pdaxrom/Z-pdaXrom-TV/projects/pal-color-demo/README

Original sources for Papilio TV Output Wing

http://papilio.cc/index.php?n=Playground.TVOutputWing
