pdaxrom/Z-pdaXrom-TV/hardware-lcd-sdram/main.brd

## EAGLE design hardware-lcd-sdram/main.brd (2018-05-11)

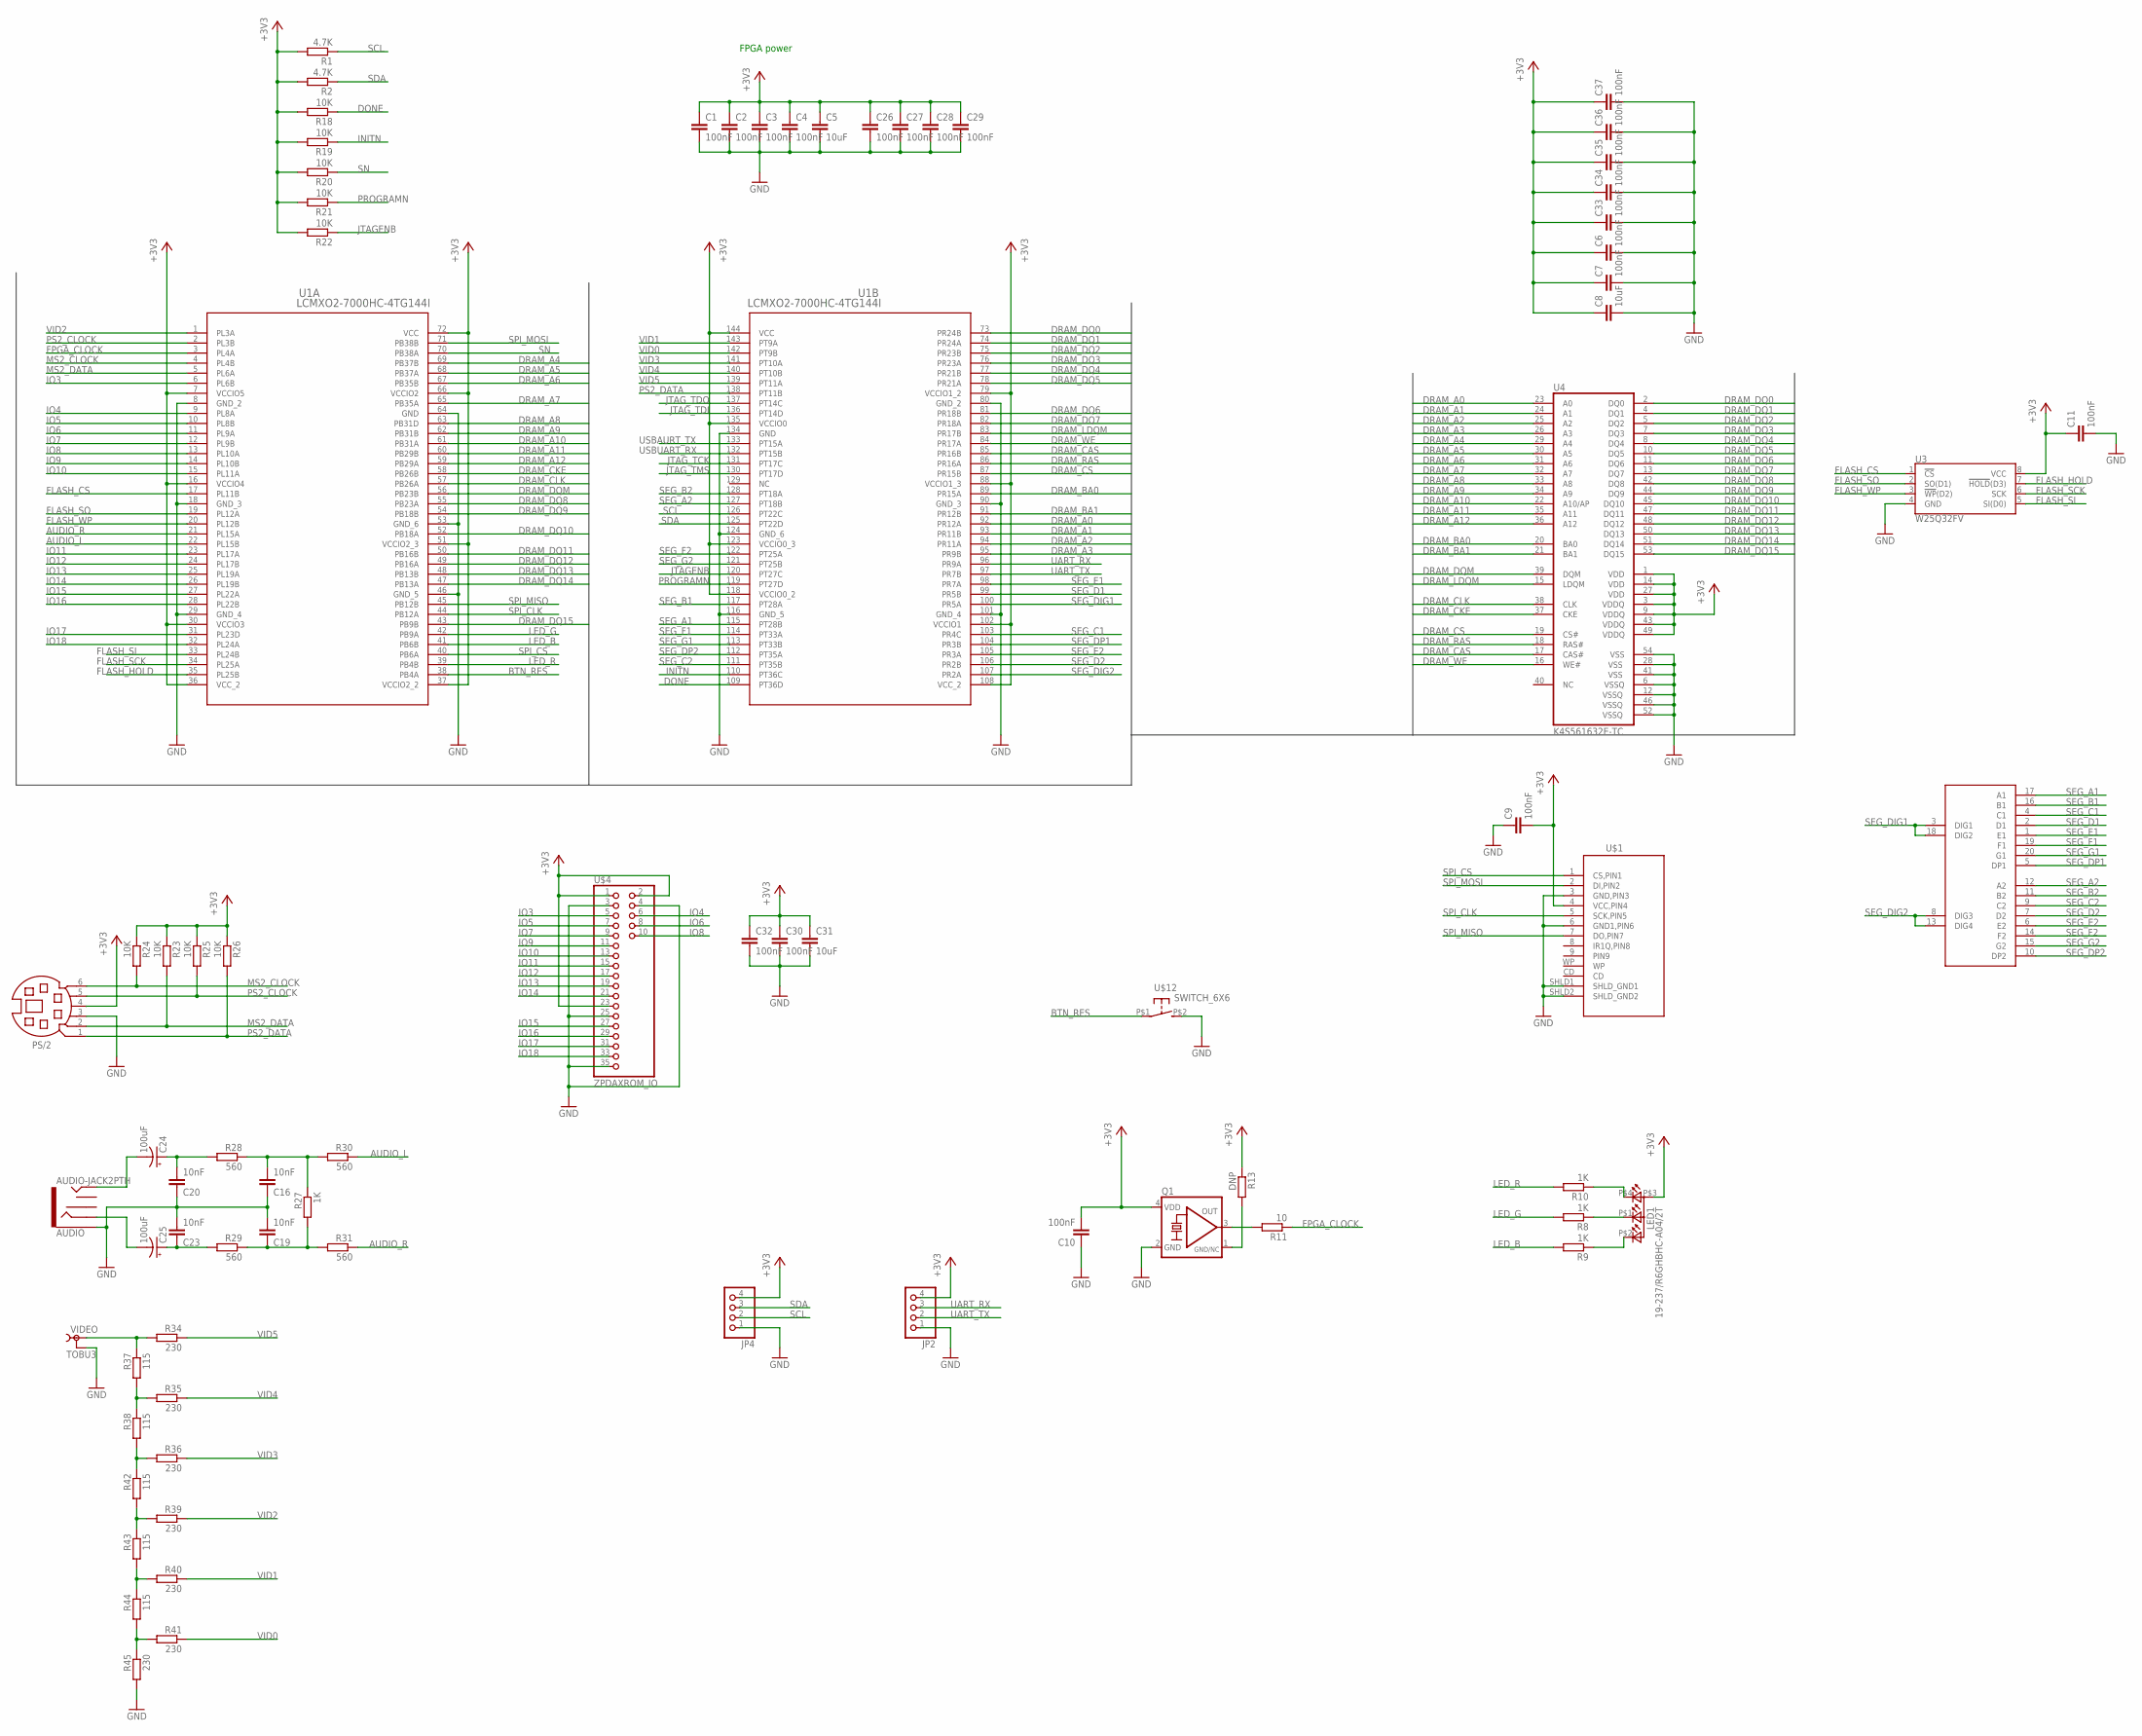
[picture p1: schematic main.sch, sheet 1]

Parts:
AUDIO: AUDIO-JACK2PTH; AUDIO-JACK
C1, C2, C3, C4, C6, C7, C9, C10, C11, C26, C27, C28, C29, C30, C32, C33, C34, C35, C36, C37: 100nF; C0603
C5, C8, C31: 10uF; C0805
C16, C19, C20, C23: 10nF; C0603
C24, C25: 100uF; EIA7343
JP2, JP4: PINHD-1X4; 1X04
LED1: 19-237/R6GHBHC-A04/2T
PS/2: MD06SS; MDIN06SS
Q1: KXO-TCXO-CMOS-82; 7.0X5.0_KXO-82-TCXO
R1, R2: 4.7K; R0603
R8, R9, R10, R27: 1K; R0603
R11: 10; R0603
R13: DNP; R0603
R18, R19, R20, R21, R22, R23, R24, R25, R26: 10K; R0603
R28, R29, R30, R31: 560; R0603
R34, R35, R36, R39, R40, R41, R45: 230; R0603
R37, R38, R42, R43, R44: 115; R0603
U1: LCMXO2-7000HC-4TG144I; TQFP144
U3: W25Q32FV; SOIC-8
U4: K4S561632E-TC; TSOP54
U$1: FCI_SD_SOCKET; SD-MMC_SOCKET-PP
U$3: GS2020CR-G; GS2020CR
U$4: ZPDAXROM_IO; 2X18_ZPDAXROM_IO
U$12: SWITCH_6X6
VIDEO: TOBU3

Connections:
+3V3: C1.1, C2.1, C3.1, C4.1, C5.1, C6.1, C7.1, C8.1, C9.2, C10.2, C11.1, C26.1, C27.1, C28.1, C29.1, C30.1, C31.1, C32.1, C33.1, C34.1, C35.1, C36.1, C37.1, JP2.4, JP4.4, LED1.P$3 (A), PS/2.4, Q1.4 (VDD), R1.2, R2.2, R13.1, R18.2, R19.2, R20.2, R21.2, R22.2, R23.1, R24.1, R25.1, R26.1, U1.7 (VCCIO5), U1.16 (VCCIO4), U1.30 (VCCIO3), U1.36 (VCC_2), U1.37 (VCCIO2_2), U1.51 (VCCIO2_3), U1.66 (VCCIO2), U1.72 (VCC), U1.79 (VCCIO1_2), U1.88 (VCCIO1_3), U1.102 (VCCIO1), U1.108 (VCC_2), U1.118 (VCCIO0_2), U1.123 (VCCIO0_3), U1.135 (VCCIO0), U1.144 (VCC), U3.8 (VCC), U4.1 (VDD), U4.3 (VDDQ), U4.9 (VDDQ), U4.14 (VDD), U4.27 (VDD), U4.43 (VDDQ), U4.49 (VDDQ), U$1.4 (VCC,PIN4), U$4.1, U$4.2, U$4.23; also elsewhere on the board
AUDIO_L: R30.1, U1.22 (PL15B)
AUDIO_R: R31.1, U1.21 (PL15A)
BTN_RES: U1.38 (PB4A), U$12.P$1
DONE: R18.1, U1.109 (PT36D)
DRAM_A0: U1.92 (PR12A), U4.23 (A0)
DRAM_A1: U1.93 (PR11B), U4.24 (A1)
DRAM_A2: U1.94 (PR11A), U4.25 (A2)
DRAM_A3: U1.95 (PR9B), U4.26 (A3)
DRAM_A4: U1.69 (PB37B), U4.29 (A4)
DRAM_A5: U1.68 (PB37A), U4.30 (A5)
DRAM_A6: U1.67 (PB35B), U4.31 (A6)
DRAM_A7: U1.65 (PB35A), U4.32 (A7)
DRAM_A8: U1.63 (PB31D), U4.33 (A8)
DRAM_A9: U1.62 (PB31B), U4.34 (A9)
DRAM_A10: U1.61 (PB31A), U4.22 (A10/AP)
DRAM_A11: U1.60 (PB29B), U4.35 (A11)
DRAM_A12: U1.59 (PB29A), U4.36 (A12)
DRAM_BA0: U1.89 (PR15A), U4.20 (BA0)
DRAM_BA1: U1.91 (PR12B), U4.21 (BA1)
DRAM_CAS: U1.85 (PR16B), U4.17 (CAS#)
DRAM_CKE: U1.58 (PB26B), U4.37 (CKE)
DRAM_CLK: U1.57 (PB26A), U4.38 (CLK)
DRAM_CS: U1.87 (PR15B), U4.19 (CS#)
DRAM_DQ0: U1.73 (PR24B), U4.2 (DQ0)
DRAM_DQ1: U1.74 (PR24A), U4.4 (DQ1)
DRAM_DQ2: U1.75 (PR23B), U4.5 (DQ2)
DRAM_DQ3: U1.76 (PR23A), U4.7 (DQ3)
DRAM_DQ4: U1.77 (PR21B), U4.8 (DQ4)
DRAM_DQ5: U1.78 (PR21A), U4.10 (DQ5)
DRAM_DQ6: U1.81 (PR18B), U4.11 (DQ6)
DRAM_DQ7: U1.82 (PR18A), U4.13 (DQ7)
DRAM_DQ8: U1.55 (PB23A), U4.42 (DQ8)
DRAM_DQ9: U1.54 (PB18B), U4.44 (DQ9)
DRAM_DQ10: U1.52 (PB18A), U4.45 (DQ10)
DRAM_DQ11: U1.50 (PB16B), U4.47 (DQ11)
DRAM_DQ12: U1.49 (PB16A), U4.48 (DQ12)
DRAM_DQ13: U1.48 (PB13B), U4.50 (DQ13)
DRAM_DQ14: U1.47 (PB13A), U4.51 (DQ14)
DRAM_DQ15: U1.43 (PB9B), U4.53 (DQ15)
DRAM_DQM: U1.56 (PB23B), U4.39 (DQM)
DRAM_LDQM: U1.83 (PR17B), U4.15 (LDQM)
DRAM_RAS: U1.86 (PR16A), U4.18 (RAS#)
DRAM_WE: U1.84 (PR17A), U4.16 (WE#)
FLASH_CS: U1.17 (PL11B), U3.1 (!CS!)
FLASH_HOLD: U1.35 (PL25B), U3.7 (!HOLD!(D3))
FLASH_SCK: U1.34 (PL25A), U3.6 (SCK)
FLASH_SI: U1.33 (PL24B), U3.5 (SI(D0))
FLASH_SO: U1.19 (PL12A), U3.2 (SO(D1))
FLASH_WP: U1.20 (PL12B), U3.3 (!WP!(D2))
FPGA_CLOCK: R11.1, U1.3 (PL4A)
GND: AUDIO.SLEEVE, C1.2, C2.2, C3.2, C4.2, C5.2, C6.2, C7.2, C8.2, C9.1, C10.1, C11.2, C16.1, C19.2, C20.1, C23.2, C26.2, C27.2, C28.2, C29.2, C30.2, C31.2, C32.2, C33.2, C34.2, C35.2, C36.2, C37.2, JP2.1, JP4.1, PS/2.3, Q1.2 (GND), R45.2, U1.8 (GND_2), U1.18 (GND_3), U1.29 (GND_4), U1.46 (GND_5), U1.53 (GND_6), U1.64 (GND), U1.80 (GND_2), U1.90 (GND_3), U1.101 (GND_4), U1.116 (GND_5), U1.124 (GND_6), U1.134 (GND), U3.4 (GND), U4.6 (VSSQ), U4.12 (VSSQ), U4.28 (VSS), U4.41 (VSS), U4.46 (VSSQ), U4.52 (VSSQ), U4.54 (VSS), U$1.3 (GND,PIN3), U$1.6 (GND1,PIN6), U$1.SHLD1 (SHLD_GND1), U$1.SHLD2 (SHLD_GND2), U$4.3, U$4.4, U$4.25, U$4.35, U$12.P$2 (S), VIDEO.2, VIDEO.2@1 (2), VIDEO.2@2 (2); also elsewhere on the board
INITN: R19.1, U1.110 (PT36C)
IO3: U1.6 (PL6B), U$4.5
IO4: U1.9 (PL8A), U$4.6
IO5: U1.10 (PL8B), U$4.7
IO6: U1.11 (PL9A), U$4.8
IO7: U1.12 (PL9B), U$4.9
IO8: U1.13 (PL10A), U$4.10
IO9: U1.14 (PL10B), U$4.11
IO10: U1.15 (PL11A), U$4.13
IO11: U1.23 (PL17A), U$4.15
IO12: U1.24 (PL17B), U$4.17
IO13: U1.25 (PL19A), U$4.19
IO14: U1.26 (PL19B), U$4.21
IO15: U1.27 (PL22A), U$4.27
IO16: U1.28 (PL22B), U$4.29
IO17: U1.31 (PL23D), U$4.31
IO18: U1.32 (PL24A), U$4.33
JTAGENB: R22.1, U1.120 (PT27C)
JTAG_TCK: U1.131 (PT17C); also elsewhere on the board
JTAG_TDI: U1.136 (PT14D); also elsewhere on the board
JTAG_TDO: U1.137 (PT14C); also elsewhere on the board
JTAG_TMS: U1.130 (PT17D); also elsewhere on the board
LED_B: R9.2, U1.41 (PB6B)
LED_G: R8.2, U1.42 (PB9A)
LED_R: R10.2, U1.39 (PB4B)
MS2_CLOCK: PS/2.6, R24.2, U1.4 (PL4B)
MS2_DATA: PS/2.2, R23.2, U1.5 (PL6A)
unnamed: LED1.P$4 (CRED), R10.1
unnamed: Q1.3 (OUT), R11.2
unnamed: LED1.P$1 (CBLUE), R8.1
unnamed: LED1.P$2 (CGREEN), R9.1
unnamed: Q1.1 (GND/NC), R13.2
unnamed: C19.1, R27.2, R29.1, R31.2
unnamed: C16.2, R27.1, R28.1, R30.2
unnamed: AUDIO.TIP, C24.C (-)
unnamed: C23.1, C25.A (+), R29.2
unnamed: C20.2, C24.A (+), R28.2
unnamed: AUDIO.RING, C25.C (-)
unnamed: R34.2, R37.1, VIDEO.1
unnamed: R35.2, R37.2, R38.1
unnamed: R36.2, R38.2, R42.1
unnamed: R39.2, R42.2, R43.1
unnamed: R40.2, R43.2, R44.1
unnamed: R41.2, R44.2, R45.1
PROGRAMN: R21.1, U1.119 (PT27D)
PS2_CLOCK: PS/2.5, R25.2, U1.2 (PL3B)
PS2_DATA: PS/2.1, R26.2, U1.138 (PT11B)
SCL: JP4.2, R1.1, U1.126 (PT22C)
SDA: JP4.3, R2.1, U1.125 (PT22D)
SEG_A1: U1.115 (PT28B), U$3.17 (A1)
SEG_A2: U1.127 (PT18B), U$3.12 (A2)
SEG_B1: U1.117 (PT28A), U$3.16 (B1)
SEG_B2: U1.128 (PT18A), U$3.11 (B2)
SEG_C1: U1.103 (PR4C), U$3.4 (C1)
SEG_C2: U1.111 (PT35B), U$3.9 (C2)
SEG_D1: U1.99 (PR5B), U$3.2 (D1)
SEG_D2: U1.106 (PR2B), U$3.7 (D2)
SEG_DIG1: U1.100 (PR5A), U$3.3 (DIG1), U$3.18 (DIG2)
SEG_DIG2: U1.107 (PR2A), U$3.8 (DIG3), U$3.13 (DIG4)
SEG_DP1: U1.104 (PR3B), U$3.5 (DP1)
SEG_DP2: U1.112 (PT35A), U$3.10 (DP2)
SEG_E1: U1.98 (PR7A), U$3.1 (E1)
SEG_E2: U1.105 (PR3A), U$3.6 (E2)
SEG_F1: U1.114 (PT33A), U$3.19 (F1)
SEG_F2: U1.122 (PT25A), U$3.14 (F2)
SEG_G1: U1.113 (PT33B), U$3.20 (G1)
SEG_G2: U1.121 (PT25B), U$3.15 (G2)
SN: R20.1, U1.70 (PB38A)
SPI_CLK: U1.44 (PB12A), U$1.5 (SCK,PIN5)
SPI_CS: U1.40 (PB6A), U$1.1 (CS,PIN1)
SPI_MISO: U1.45 (PB12B), U$1.7 (DO,PIN7)
SPI_MOSI: U1.71 (PB38B), U$1.2 (DI,PIN2)
UART_RX: JP2.3, U1.96 (PR9A)
UART_TX: JP2.2, U1.97 (PR7B)
USBAURT_TX: U1.133 (PT15A); also elsewhere on the board
USBUART_RX: U1.132 (PT15B); also elsewhere on the board
VID0: R41.1, U1.142 (PT9B)
VID1: R40.1, U1.143 (PT9A)
VID2: R39.1, U1.1 (PL3A)
VID3: R36.1, U1.141 (PT10A)
VID4: R35.1, U1.140 (PT10B)
VID5: R34.1, U1.139 (PT11A)

Notes on the sheet:
FPGA power

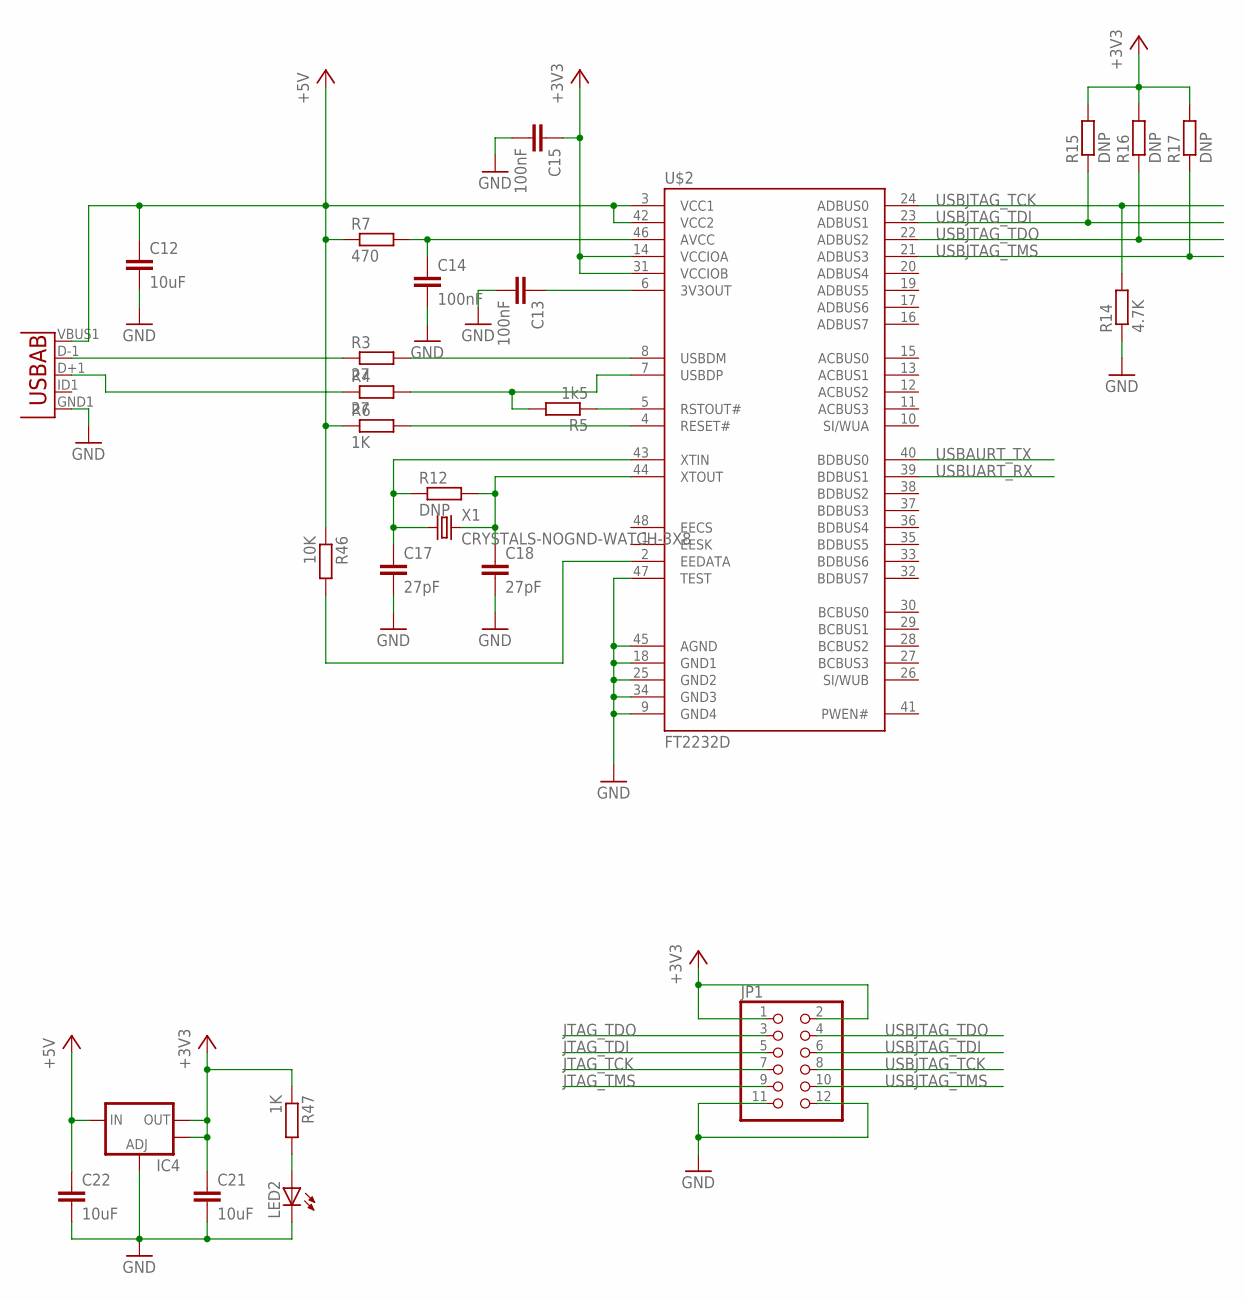
[picture p2: schematic main.sch, sheet 2]

Parts:
C12, C21, C22: 10uF; C0805
C13, C14, C15: 100nF; C0603
C17, C18: 27pF; C0603
IC4: V_REG_LM1117SOT223; SOT223
JP1: PINHD-2X6; 2X06
LED2: LEDCHIPLED_0603; CHIPLED_0603
R3, R4: 27; R0603
R5: 1k5; R0603
R6, R47: 1K; R0603
R7: 470; R0603
R12, R15, R16, R17: DNP; R0603
R14: 4.7K; R0603
R46: 10K; R0603
U2: USB""; USB-MICRO-SMD
U$2: FT2232D; LQFP-48
X1: CRYSTALS-NOGND-WATCH-3X8; WATCH-3X8

Connections:
+3V3: C15.1, C21.1, IC4.2 (OUT), IC4.4 (OUT), JP1.1, JP1.2, R15.2, R16.2, R17.2, R47.1, U$2.14 (VCCIOA), U$2.31 (VCCIOB); also elsewhere on the board
+5V: C12.1, C22.1, IC4.3 (IN), R6.1, R7.1, R46.1, U2.VBUS1 (VBUS), U$2.3 (VCC1), U$2.42 (VCC2)
GND: C12.2, C13.2, C14.2, C15.2, C17.2, C18.2, C21.2, C22.2, IC4.1 (ADJ), JP1.11, JP1.12, LED2.C, R14.1, U2.GND1 (GND), U$2.9 (GND4), U$2.18 (GND1), U$2.25 (GND2), U$2.34 (GND3), U$2.45 (AGND), U$2.47 (TEST); also elsewhere on the board
JTAG_TCK: JP1.7; also elsewhere on the board
JTAG_TDI: JP1.5; also elsewhere on the board
JTAG_TDO: JP1.3; also elsewhere on the board
JTAG_TMS: JP1.9; also elsewhere on the board
unnamed: R3.1, U2.D-1 (D-)
unnamed: R4.1, U2.D+1 (D+)
unnamed: R3.2, U$2.8 (USBDM)
unnamed: C13.1, U$2.6 (3V3OUT)
unnamed: C14.1, R7.2, U$2.46 (AVCC)
unnamed: R4.2, R5.2, U$2.7 (USBDP)
unnamed: R5.1, U$2.5 (RSTOUT#)
unnamed: R6.2, U$2.4 (RESET#)
unnamed: C17.1, R12.1, U$2.43 (XTIN), X1.1
unnamed: C18.1, R12.2, U$2.44 (XTOUT), X1.2
unnamed: R46.2, U$2.2 (EEDATA)
unnamed: LED2.A, R47.2
USBAURT_TX: U$2.40 (BDBUS0); also elsewhere on the board
USBJTAG_TCK: JP1.8, R14.2, U$2.24 (ADBUS0)
USBJTAG_TDI: JP1.6, R15.1, U$2.23 (ADBUS1)
USBJTAG_TDO: JP1.4, R16.1, U$2.22 (ADBUS2)
USBJTAG_TMS: JP1.10, R17.1, U$2.21 (ADBUS3)
USBUART_RX: U$2.39 (BDBUS1); also elsewhere on the board

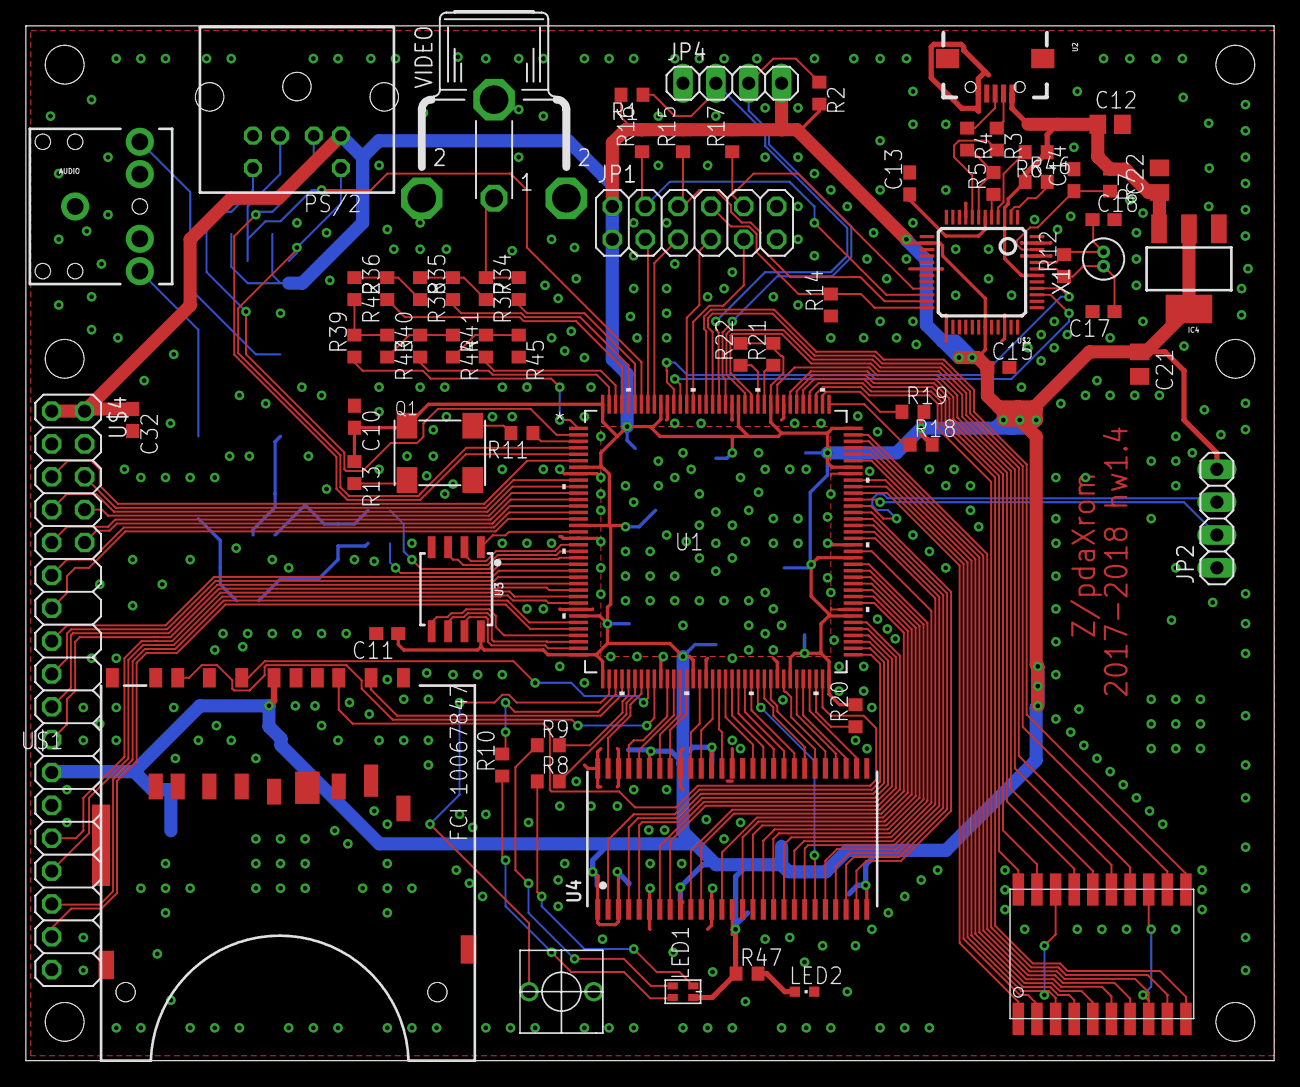
[picture p3: board main.brd from above]

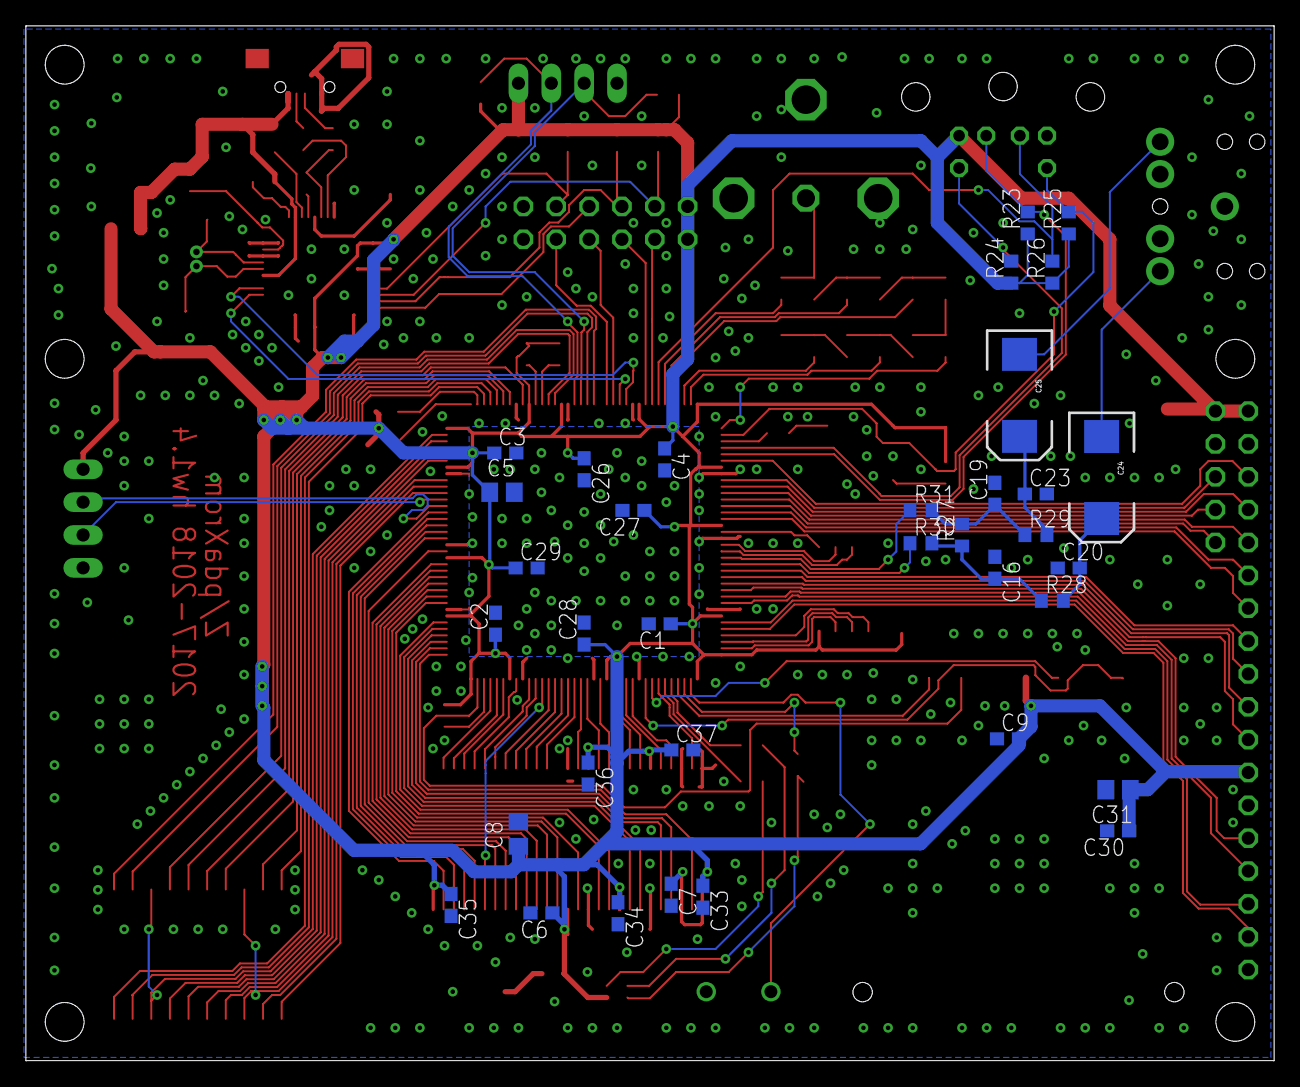
[picture p4: board main.brd from below]

Board: 2 copper layers, 96.5 x 80.0 mm, 102 parts (35 on the bottom side), 151 nets.
