pdaxrom/Z-pdaXrom-TV/(commit log)

2018-04-19 initial hw 1.3
    [bom.ods, main.brd, main.csv, main.ods, main.sch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]
2018-04-19 6MHz TSX3225 replaced with 6x3
    [main.brd, main.sch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]
2018-04-24 schematic fixes
    [main.brd, main.sch]
2018-04-24 first project - rgb leds, hex counter and reset
    [rgb.v, segled.v]
2018-04-24 6-bit video dac
    [main.brd, main.sch]
2018-04-24 pal color demo (papilio tv output wing)
2018-04-24 fixed new board
2018-04-24 Schematic and pcb fixes. Removed vid6 from video dac, io0 from GPIO port. Missed keyboard lines connected: ps2data to vid6, ps2clk to io0
    [main.brd, main.sch]
2018-04-26 3.5 inch spi lcd port added
    [bom.ods, main.brd, main.ods, main.sch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]
2018-04-27 fixed vpu logic, bus ready signal added
    [RAMCHKX.ASM, ROM.ASM, p601zero_plus.v, simpleio.v, vpu.v]
2018-05-11 SRAM replaced with SDRAM
    [main.brd, main.sch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]
2018-05-11 sd card r/w driver test
